filipnet/weatherstation/rain-gauge-calibration.xlsx

Input |  | Value | Unit | Description
Round rain gauge | Diameter | 135 | mm
 | Area | 143.0662 | cm²
Rectangular rain gauge | Length | 200 | mm
 | Width | 70 | mm
 | Area | 140.0000 | cm²
 | Now that the area of the inlet-opening has been determined, the actual measurement can begin. For this purpose, at least 100ml of water is slowly filled in next to the inlet opening of the rain gauge (i.e. into the funnel not into the opening). A larger quantity leads to a more accurate measurement result.
 | Filling quantity | 200 | ml
 |  | 0.2 | l
 | Now count the number of pulses until all the water has passed through the rain gauge. If the rain gauge is already connected to the microcontroller this can be done electronically.
 | Number of pulses after measurement | 86 | counts | ± 1 Rocker tilting
Output / Results
 | As a result we get (see formulas in Excel) the volume per rocking tray and the litres per m², which was calculated per pulse/tick and can easily be multiplied up.
 | Volume of the rocking tray | 2.325581395 | ml
Round rain gauge | Litres/m² per pulse | 0.1626 | Litres/m²
Rectangular rain gauge | Litres/m² per pulse | 0.1661 | Litres/m²
