filipnet/weatherstation/src/config.h

#define RELAY_PUMP D1
#define RELAY_SOCKET D2
#define SDA_PIN D2 // dataPin
#define SCL_PIN D1 // clockPin
#define REED_PIN D3 // internal 10k pull-up
// D4 BUILTIN_LED so do not use, internal 10k pull-up
#define HEARTBEAT_INTERVALL 512000
#define MEASUREMENT_INTERVAL 18000
