filipnet/weatherstation/(commit log)

2022-09-11 FS200-SHT10 soil temperature and humidity sensor
2022-09-14 Wrong PIN
